AINxStep/star-wars-pocket-datapad/docs/blueprints/es3c28p_blueprint_sheet2_front_bezel.png

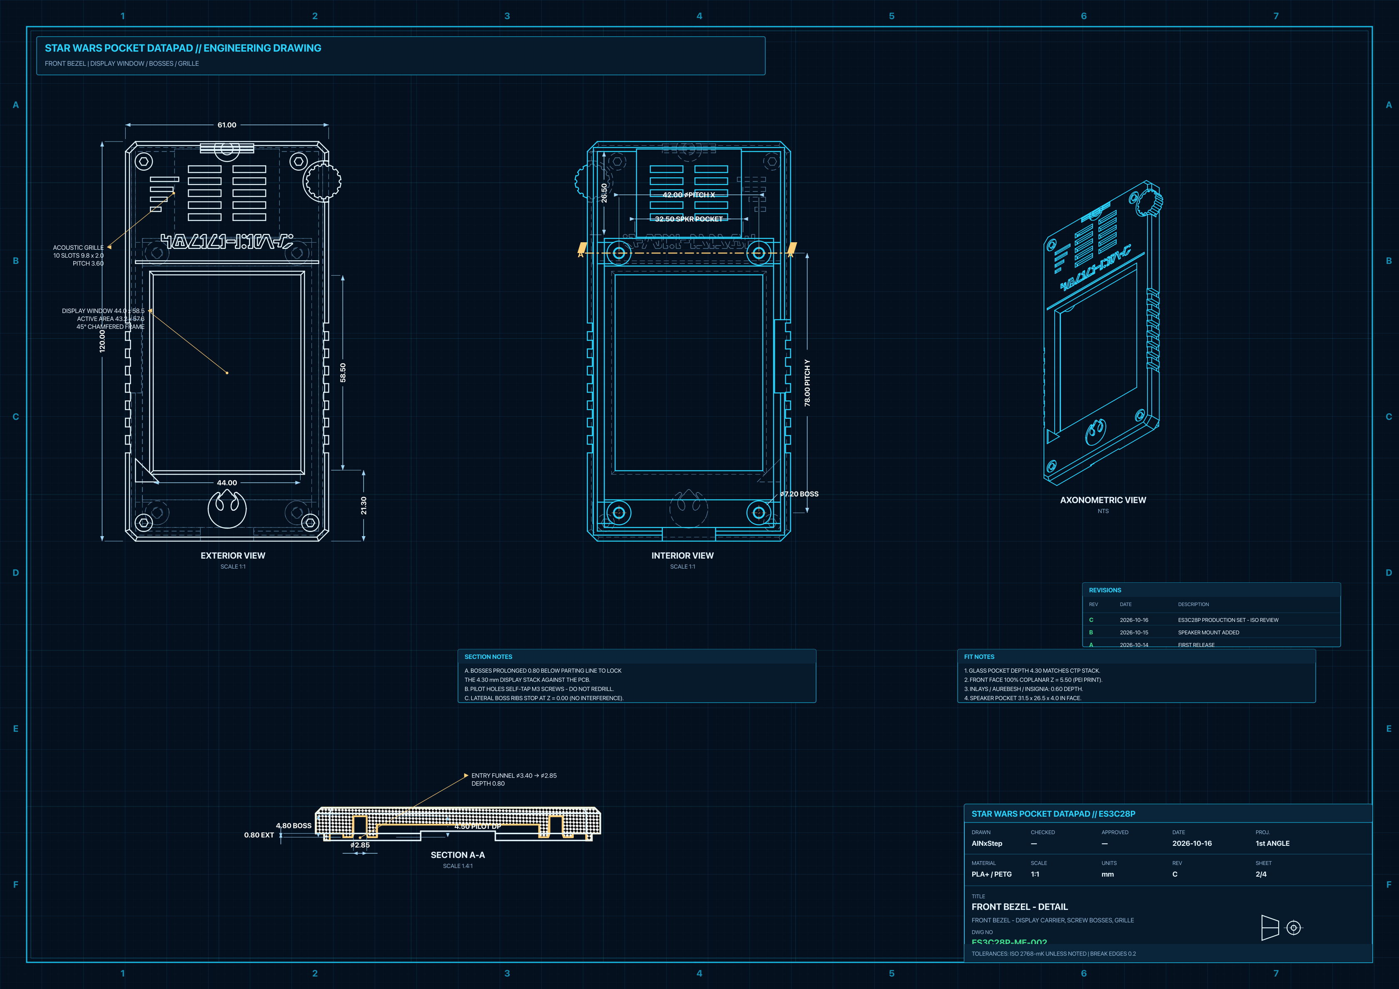
docs/blueprints/es3c28p_blueprint_sheet2_front_bezel.png
