AINxStep/star-wars-pocket-datapad/docs/blueprints/es3c28p_blueprint_sheet3_rear_chassis.png

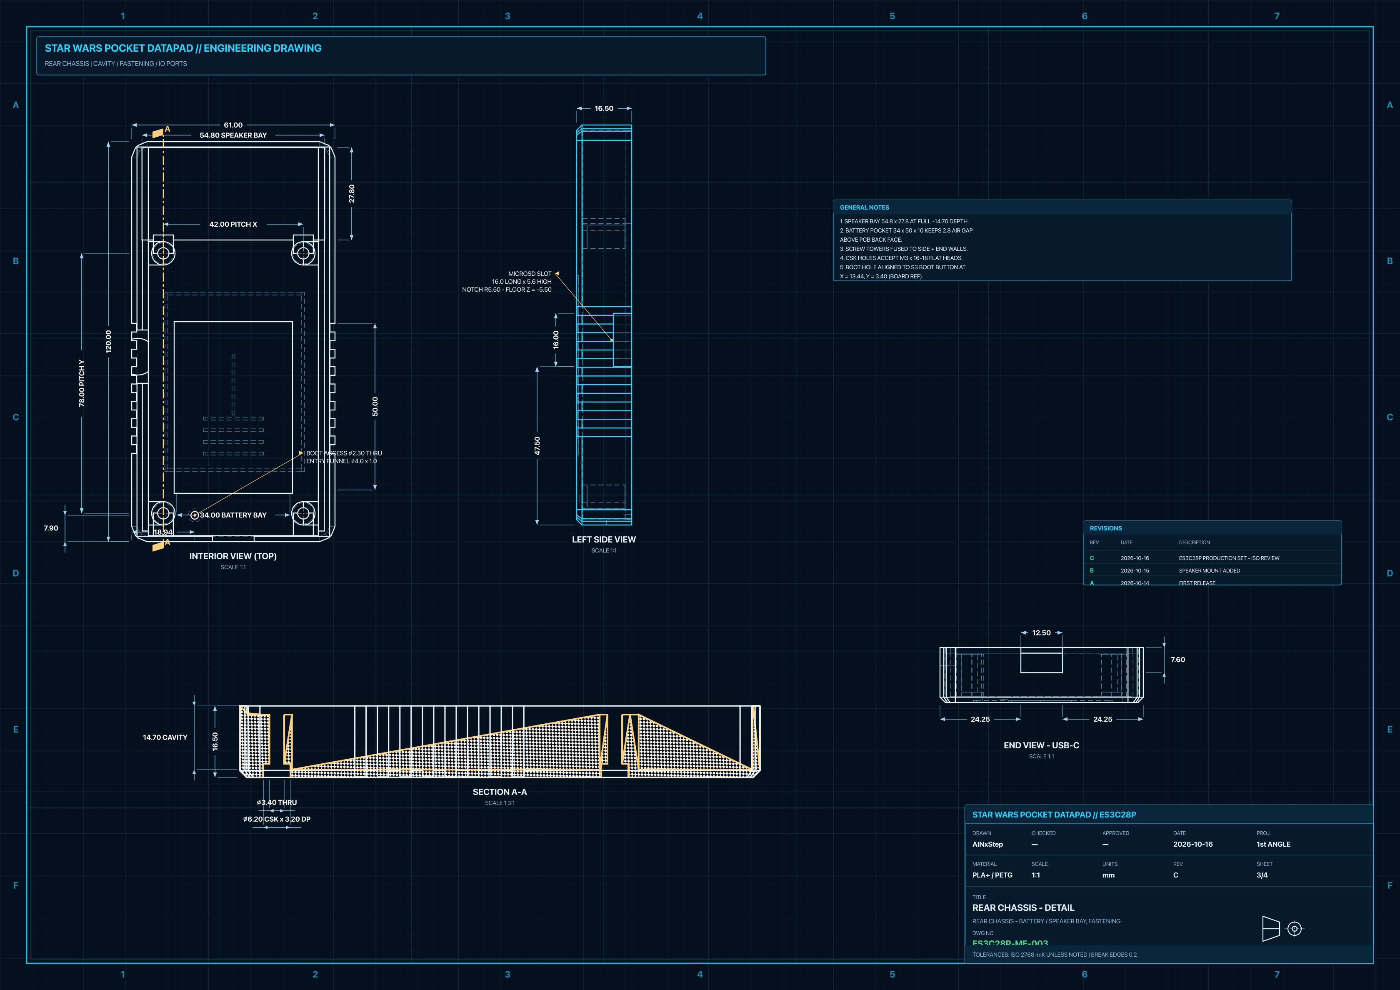
docs/blueprints/es3c28p_blueprint_sheet3_rear_chassis.png
