AINxStep/star-wars-pocket-datapad/3DPrints/datapad/ES3C28P_StarWars_Pocket_Datapad_Assembly.step

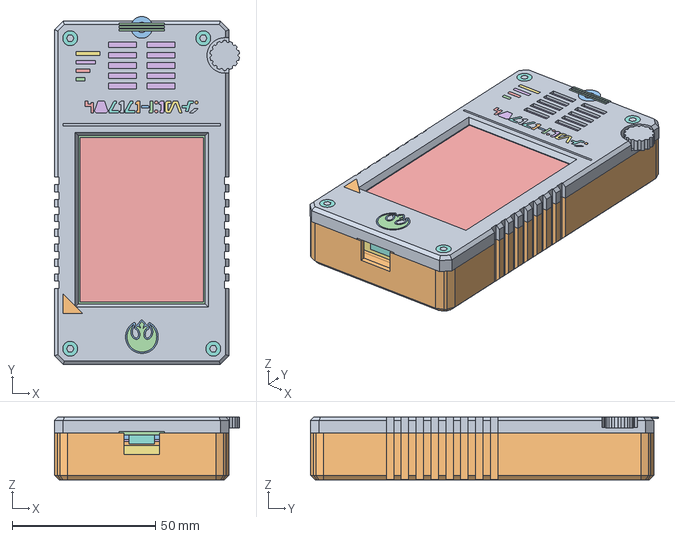
[picture p16: CAD file, 2026-10-16]
3DPrints/datapad/ES3C28P_StarWars_Pocket_Datapad_Assembly.step
64.7 x 121.6 x 22.0 mm
