AINxStep/star-wars-pocket-datapad/3DPrints/stand/StarWars_Stand_Assembly.step

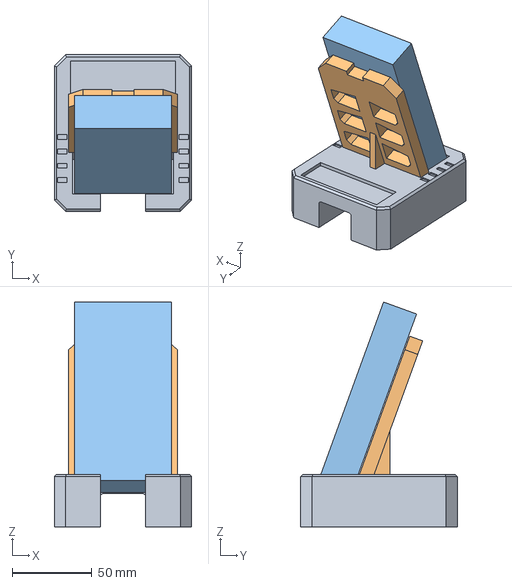
[picture p17: CAD file, 2026-10-16]
3DPrints/stand/StarWars_Stand_Assembly.step
86.0 x 98.0 x 140.8 mm
