AINxStep/star-wars-pocket-datapad/3DPrints/datapad/ES3C28P_StarWars_Datapad.3mf

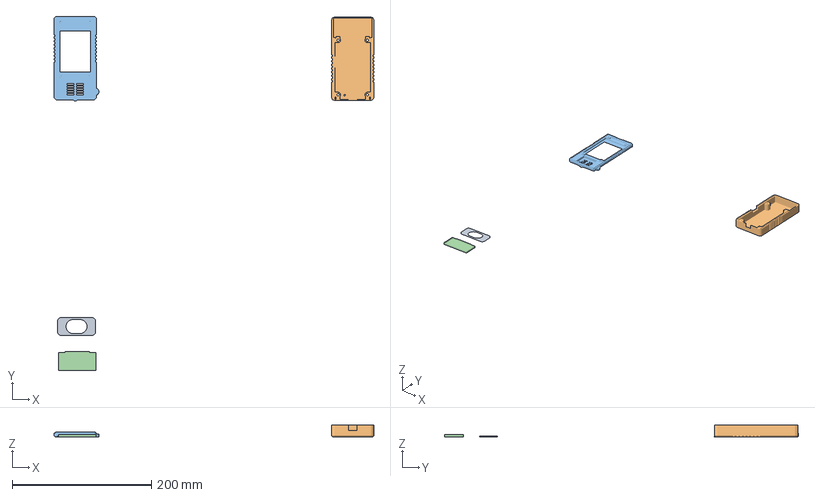
[picture p18: CAD file, 2026-10-18]
3DPrints/datapad/ES3C28P_StarWars_Datapad.3mf
458.8 x 508.1 x 16.5 mm
Rounded Box
