AINxStep/star-wars-pocket-datapad/3DPrints/stand/ES3C28P_StarWars_Stand.3mf

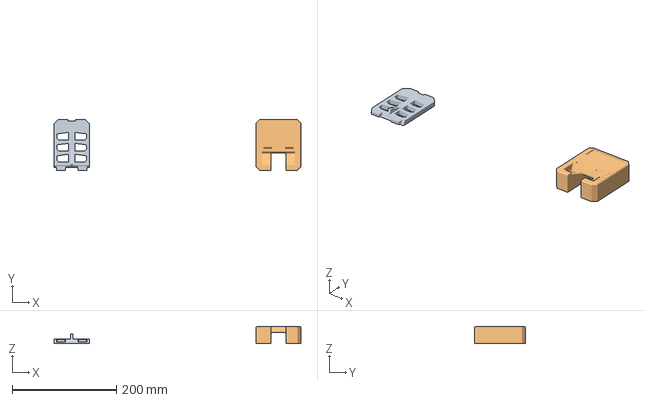
[picture p19: CAD file, 2026-10-18]
3DPrints/stand/ES3C28P_StarWars_Stand.3mf
473.0 x 98.5 x 33.0 mm
