AINxStep/star-wars-pocket-datapad/3DPrints/datapad/ES3C28P_StarWars_Speaker_Mount_b.step

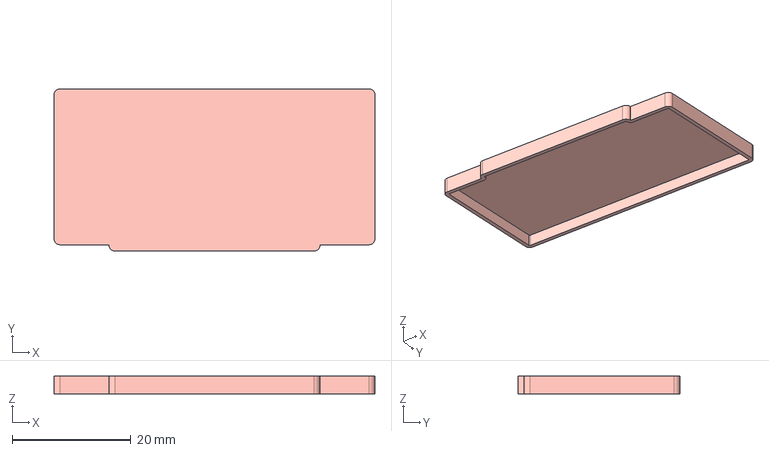
[picture p20: CAD file, 2026-10-18]
3DPrints/datapad/ES3C28P_StarWars_Speaker_Mount_b.step
54.0 x 27.3 x 3.00 mm
