AINxStep/star-wars-pocket-datapad/3DPrints/stand/StarWars_Stand_Base.step

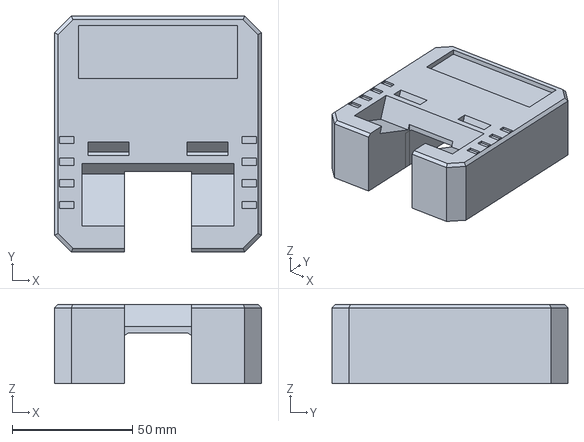
[picture p21: CAD file, 2026-10-16]
3DPrints/stand/StarWars_Stand_Base.step
86.0 x 98.0 x 33.0 mm
