AINxStep/star-wars-pocket-datapad/3DPrints/datapad/ES3C28P_StarWars_Front_Bezel.step

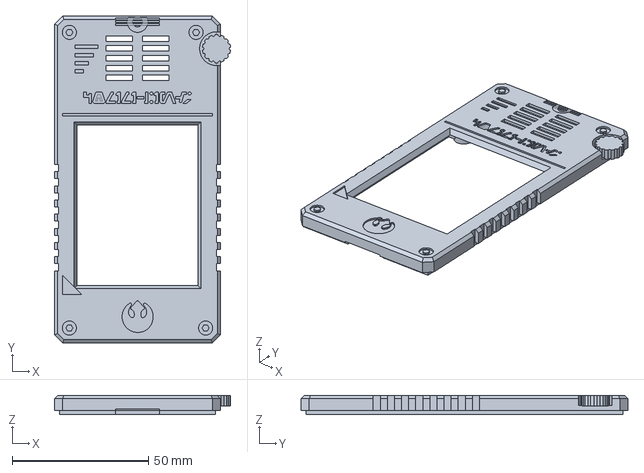
[picture p22: CAD file, 2026-10-16]
3DPrints/datapad/ES3C28P_StarWars_Front_Bezel.step
64.7 x 120.0 x 7.00 mm
