AINxStep/star-wars-pocket-datapad/3DPrints/stand/StarWars_Stand_Cradle.step

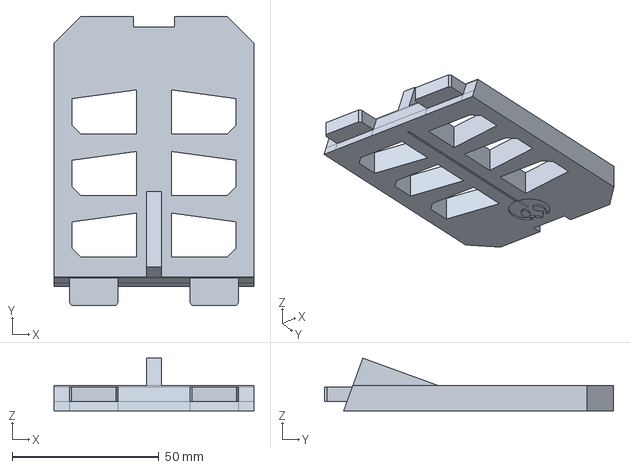
[picture p23: CAD file, 2026-10-16]
3DPrints/stand/StarWars_Stand_Cradle.step
68.0 x 98.5 x 18.0 mm
