AINxStep/star-wars-pocket-datapad/3DPrints/datapad/ES3C28P_StarWars_Front_Bezel_Multicolor.step

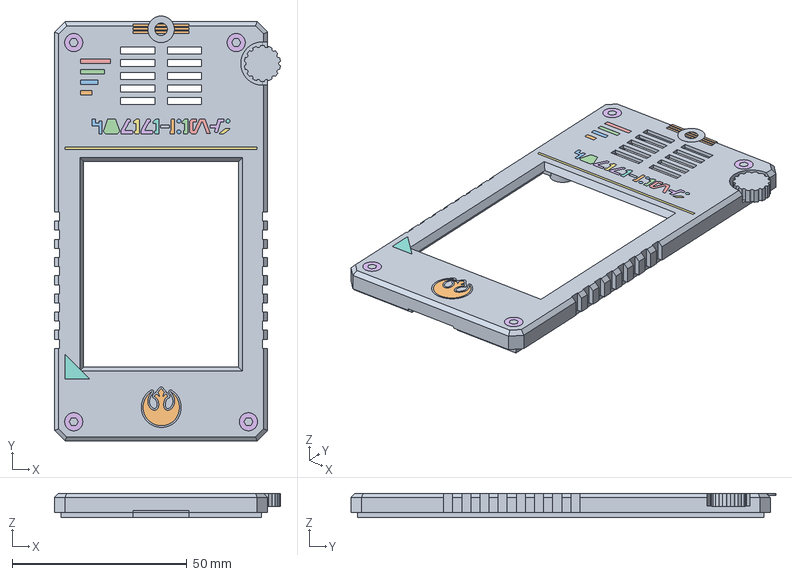
[picture p24: CAD file, 2026-10-16]
3DPrints/datapad/ES3C28P_StarWars_Front_Bezel_Multicolor.step
64.7 x 121.6 x 7.00 mm
