AINxStep/star-wars-pocket-datapad/3DPrints/datapad/ES3C28P_StarWars_Speaker_Mount.step

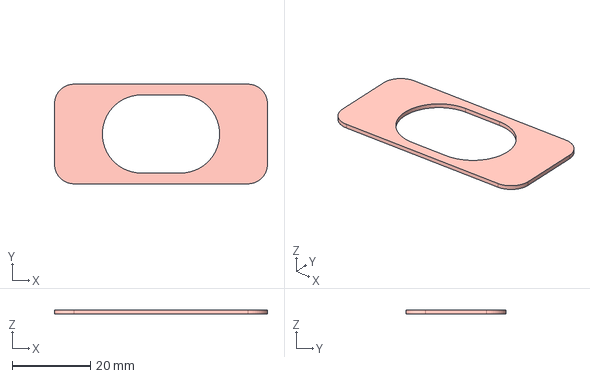
[picture p25: CAD file, 2026-10-16]
3DPrints/datapad/ES3C28P_StarWars_Speaker_Mount.step
54.5 x 25.5 x 1.00 mm
