AINxStep/star-wars-pocket-datapad/3DPrints/datapad/ES3C28P_StarWars_Rear_Chassis.step

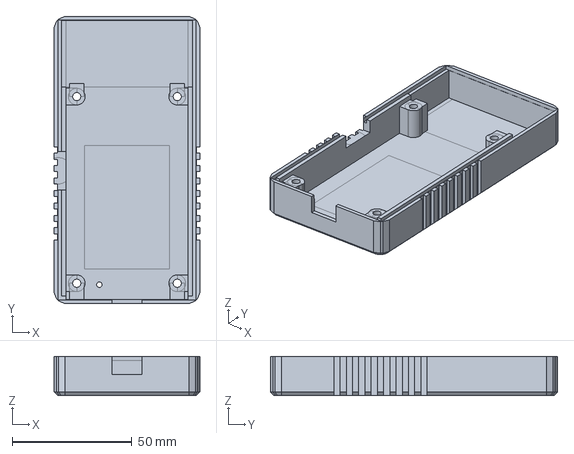
[picture p26: CAD file, 2026-10-16]
3DPrints/datapad/ES3C28P_StarWars_Rear_Chassis.step
61.0 x 120.0 x 16.5 mm
