AINxStep/star-wars-pocket-datapad/(list of files, cad)

Other CAD files:
3DPrints/stand/StarWars_Stand_Cradle_Multicolor.step
3DPrints/datapad/ES3C28P_StarWars_Rear_Chassis.stl
3DPrints/datapad/ES3C28P_StarWars_Speaker_Mount.stl
3DPrints/datapad/ES3C28P_StarWars_Speaker_Mount_b.stl
3DPrints/stand/StarWars_Stand_Base.stl
3DPrints/stand/StarWars_Stand_Cradle.stl
