AINxStep/star-wars-pocket-datapad/docs/blueprints/es3c28p_blueprint_sheet1_assembly.pdf

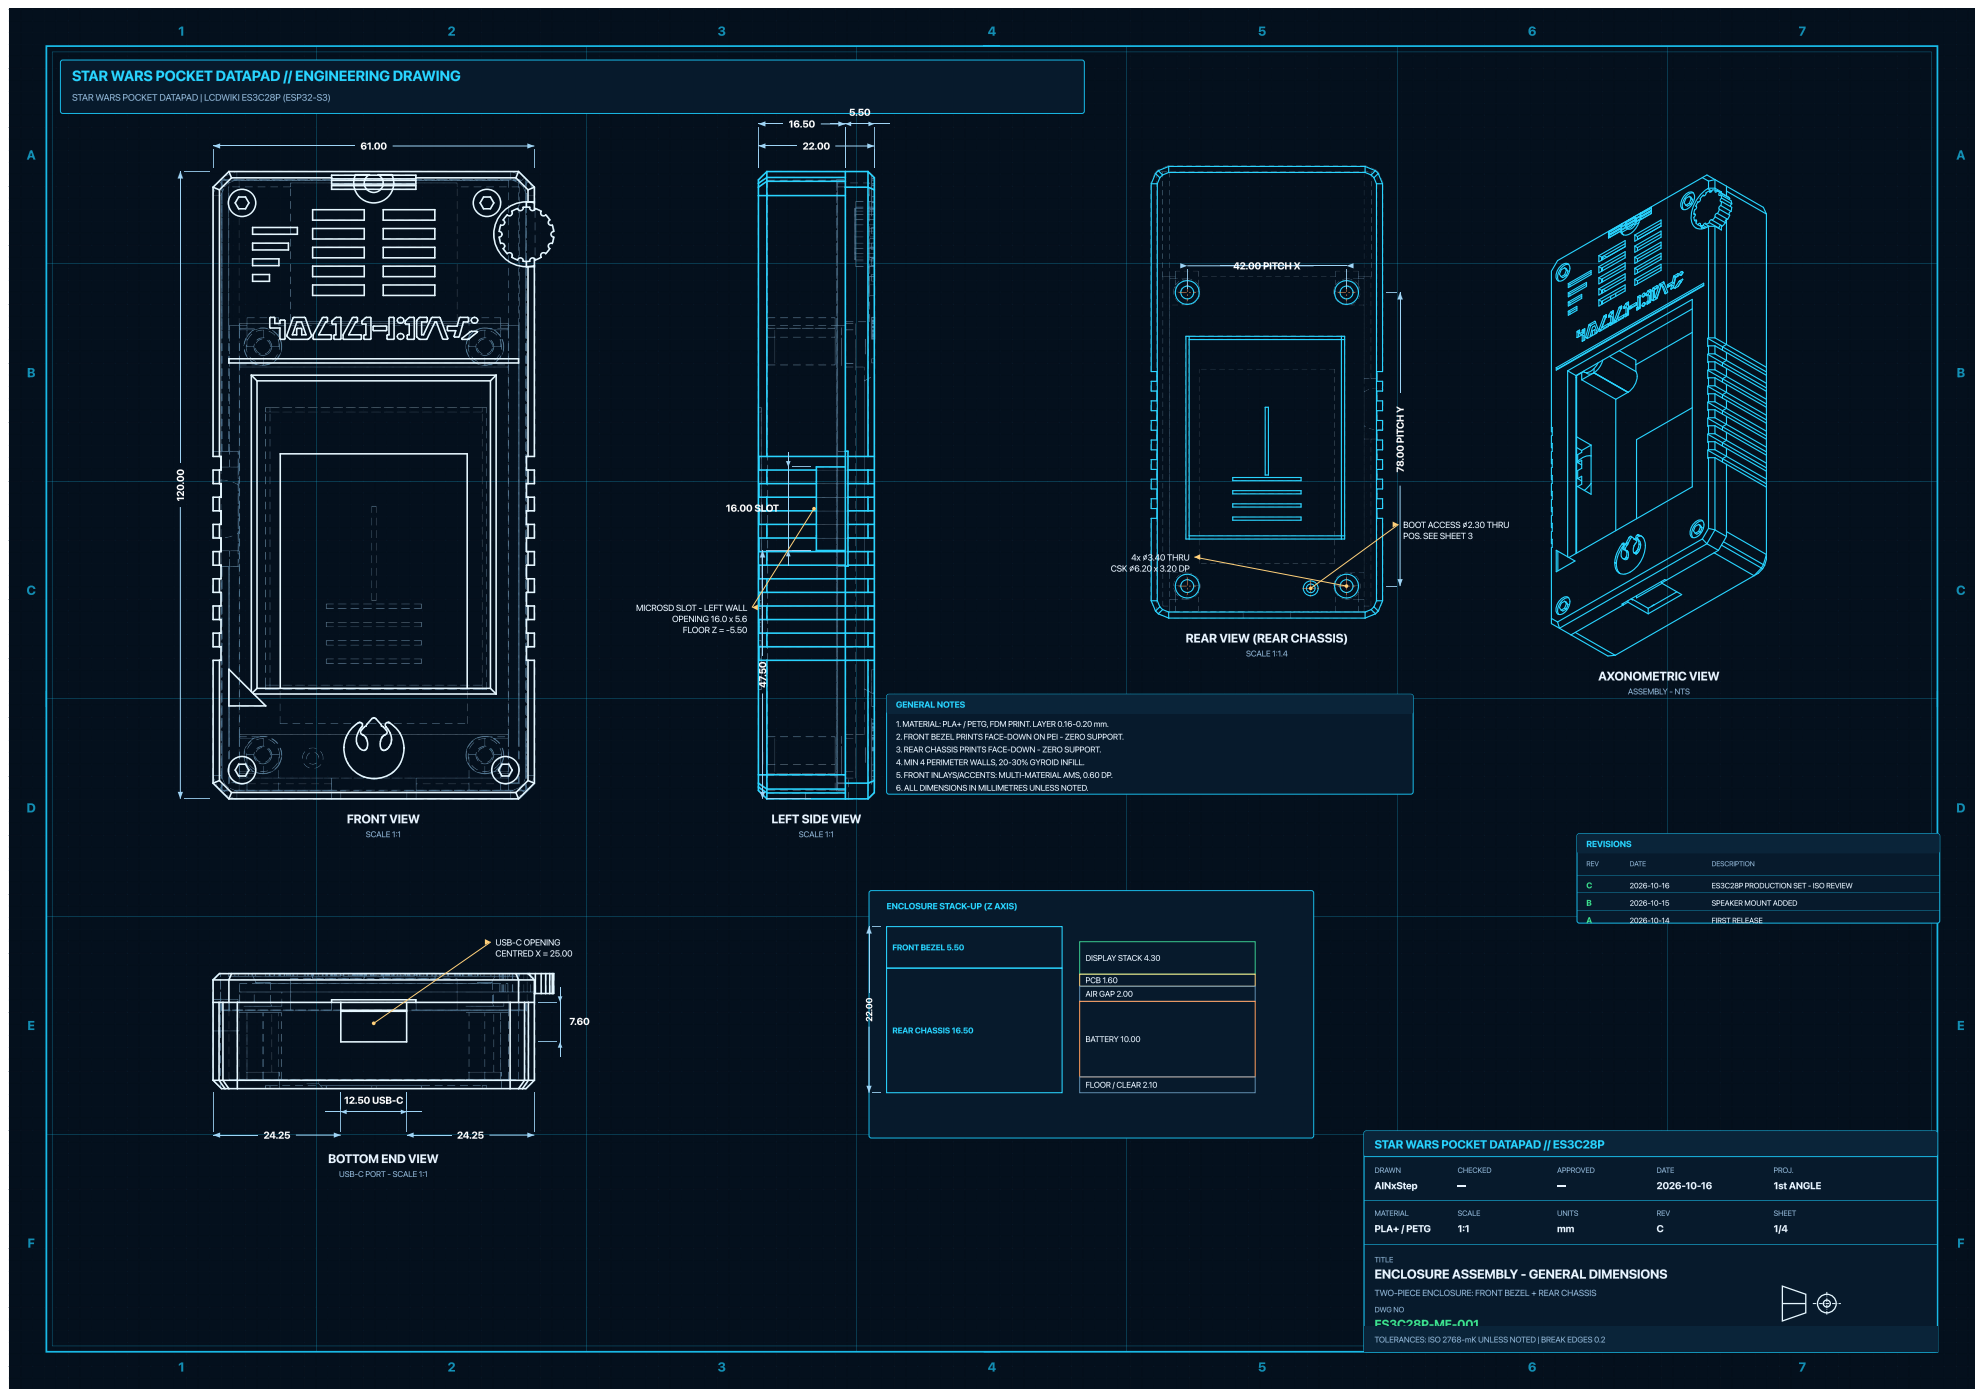
[picture p27: page 1]
