AINxStep/star-wars-pocket-datapad/docs/blueprints/es3c28p_blueprint_sheet4_speaker_mount.pdf

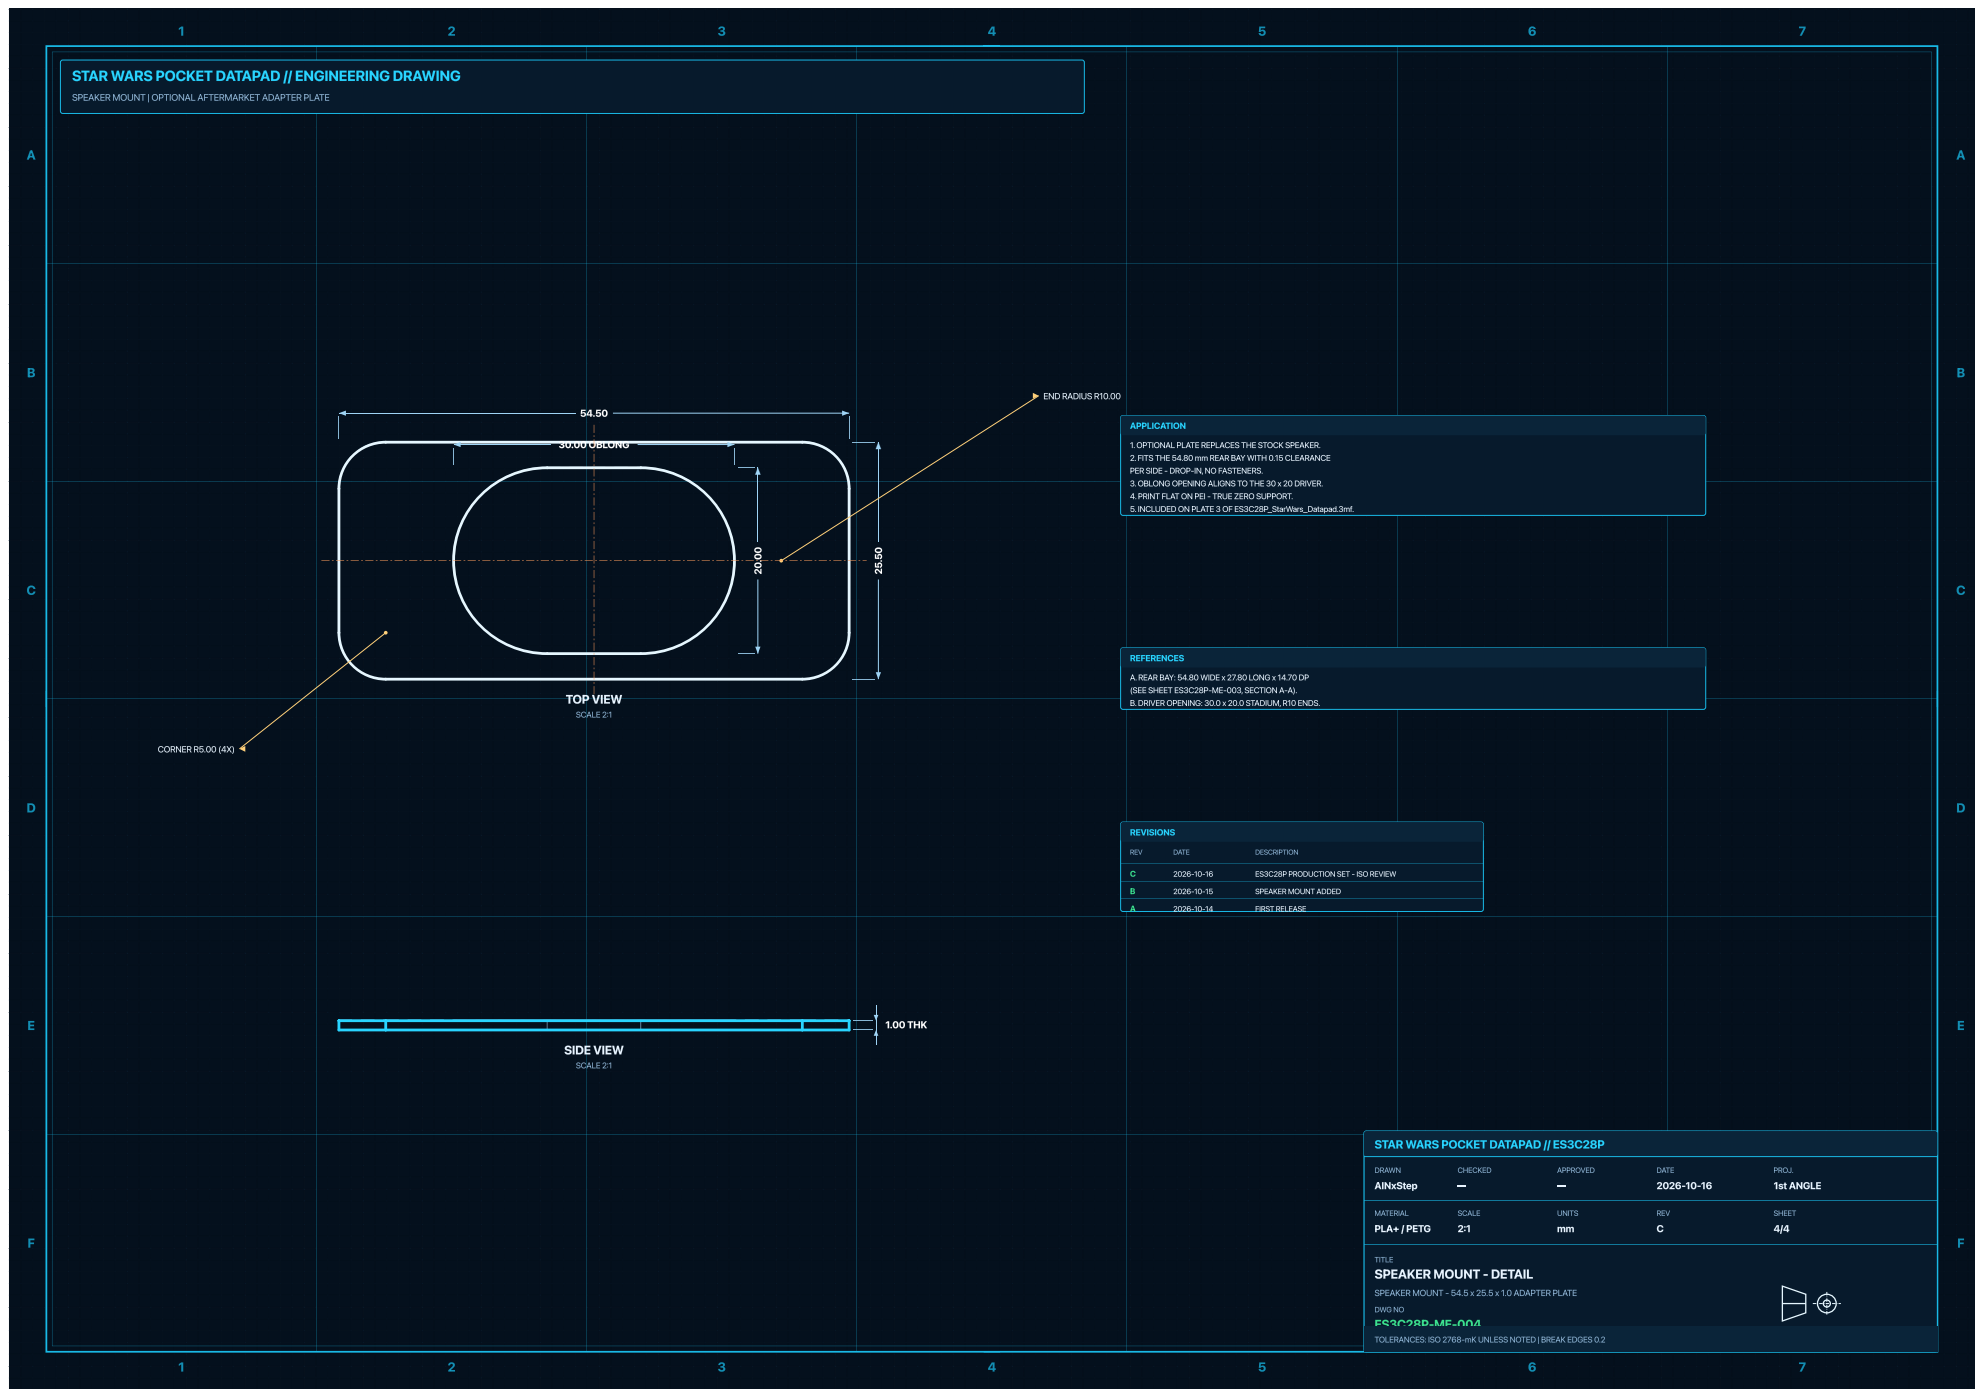
[picture p30: page 1]
