AINxStep/star-wars-pocket-datapad/(commit log)

2026-10-16 Initial commit: Star Wars Pocket Datapad (ES3C28P)
    Touch firmware for the LCDWIKI ES3C28P (ESP32-S3, 240x320 ILI9341V,
    FT6336G touch, ES8311 codec): LVGL 8.4 UI with radar, hologram
    projector, comlink soundboard, Aurebesh keyboard, star chart, morse
    beacon, ESP-NOW link, themes and EN/ES/Aurebesh i18n.
    - firmware/: PlatformIO project, single env esp32-s3-es3c28p
    - simulator/: WASM build of the real UI (Emscripten + browser shims)
    - 3DPrints/: enclosure and desktop stand exports (3MF, STL, STEP)
    - docs/: bilingual enclosure docs, 4-sheet engineering blueprint set
    - GitHub Pages workflow builds and deploys the simulator
    [ES3C28P_StarWars_Datapad.3mf, ES3C28P_StarWars_Front_Bezel.step, ES3C28P_StarWars_Front_Bezel_Multicolor.step, ES3C28P_StarWars_Pocket_Datapad_Assembly.step, ES3C28P_StarWars_Rear_Chassis.step, ES3C28P_StarWars_Rear_Chassis.stl, ES3C28P_StarWars_Speaker_Mount.step, ES3C28P_StarWars_Speaker_Mount.stl]
2026-10-16 Docs: name the board ES3C28P, not LCDWIKI
    LCDWIKI is a wiki documenting LCD modules, not the board's maker.
    Keep it only where it is cited as the documentation source (IO
    allocation table, display module drawing).
2026-10-16 Docs: clarify rear chassis ships with optional supports enabled
    The .3mf project enables supports on the rear chassis plate even though
    the part is designed to print without them; front bezel and speaker
    mount remain true zero-support.
2026-10-16 Docs: add reference print job filaments and times
    Extracted from the bundled .gcode.3mf (Bambu H2C, 0.4 mm nozzle,
    0.16 mm layers, textured PEI): front bezel ~24 g multicolor PLA
    (~2h11m), rear chassis ~34 g PLA Metal graphite (~1h50m), speaker
    mount ~1 g PLA black (~11m).
2026-10-16 Docs: correct the speaker mount adapter purpose
    The stock ES3C28P speaker is a good-quality rectangular unit whose
    cable is simply too short for this case; the adapter plate mounts a
    generic rectangular replacement speaker, not a 20 mm upgrade.
2026-10-16 Docs: specify battery size, replacement speaker and M3x17 screws
    Battery must be 2000-3000 mAh to fit the bay with useful runtime;
    a generic rectangular speaker is required since the stock cable is
    too short; assembly uses 4x M3 x 17 mm screws.
2026-10-16 Firmware docs: beginner-friendly flashing guide and clearer sound docs
    Step-by-step PlatformIO flashing (VS Code GUI path and CLI path) with
    download-mode fallback; the sounds section now explains the microSD
    folder layout, the file-name table, ambient coms slots, and that clips
    should be rights-free audio.
2026-10-16 README: add hobby-project disclaimer
    Clarify the project is a fan hobby effort with no maintenance
    commitment and that it may be changed or removed at any time.
2026-10-16 README: frame the datapad as a functional prop
    Clarify it is a display/cosplay prop meant to be fun, not a
    practical device.
2026-10-16 README: mention cosplay as the prop's natural use case
2026-10-17 Add components photo and refresh .3mf project
    docs/images/components.jpg (metadata-stripped) illustrates the What
    you need list in both READMEs and the assembly kit in the enclosure
    docs. The .3mf picks up the filament dynamic map change and is
    sanitized again.
    [ES3C28P_StarWars_Datapad.3mf]
2026-10-17 Add CAD renders to the enclosure docs, move parts photo to READMEs only
    Datapad isometric/front/interior views after the master blueprint and
    stand + docked views in the stand section; the components photograph
    stays in the README parts list. PNG text chunks stripped.
2026-10-17 Show the full assembled datapad in the enclosure render views
2026-10-17 Rename assembly renders to bypass stale CDN image cache
2026-10-17 Add READMEs to 3DPrints/datapad pointing to the Release STL assets
2026-10-17 Note the release now ships the complete STL set
2026-10-18 Add Speaker_Mount_b variant, refresh project photos and document both mounts
    [ES3C28P_StarWars_Datapad.3mf, ES3C28P_StarWars_Speaker_Mount_b.step, ES3C28P_StarWars_Speaker_Mount_b.stl]
2026-10-18 Add stand 3MF project and note both pieces need supports
    [ES3C28P_StarWars_Stand.3mf]
2026-10-18 Note the stand ships as a print profile on the MakerWorld listing
