AINxStep/star-wars-pocket-datapad/(notices)

Notices in the files:
README.md:
License: MIT / CC BY-NC-SA 4.0
